25006675-png/wattseye/assets/full-system-architecture-clean.png

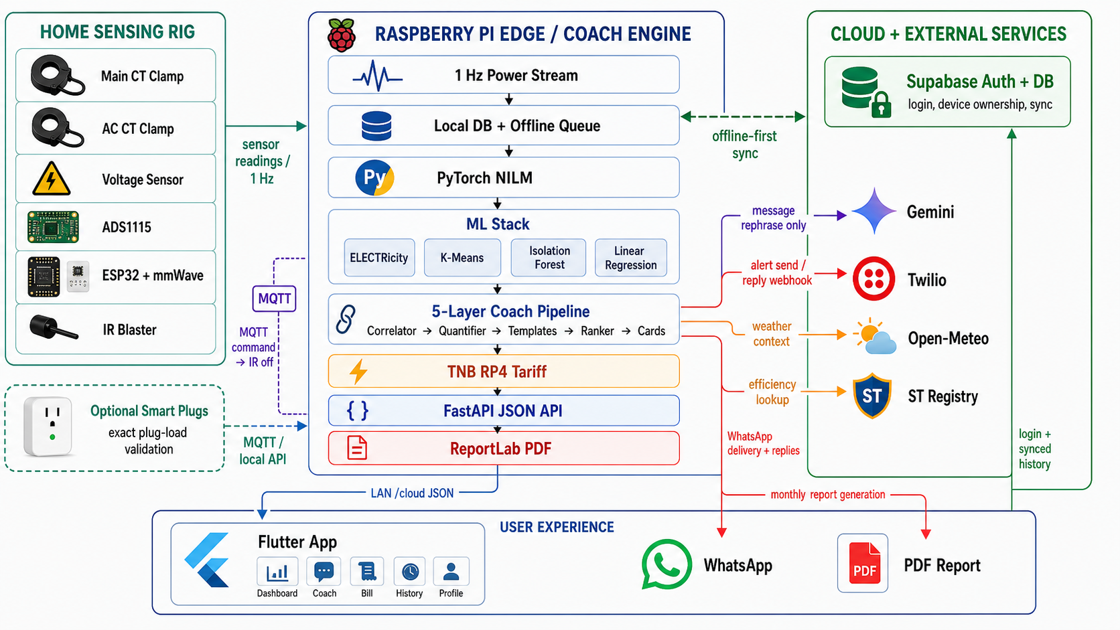
assets/full-system-architecture-clean.png
