25006675-png/wattseye/assets/wattseye-architecture-meta-cloud-api.png

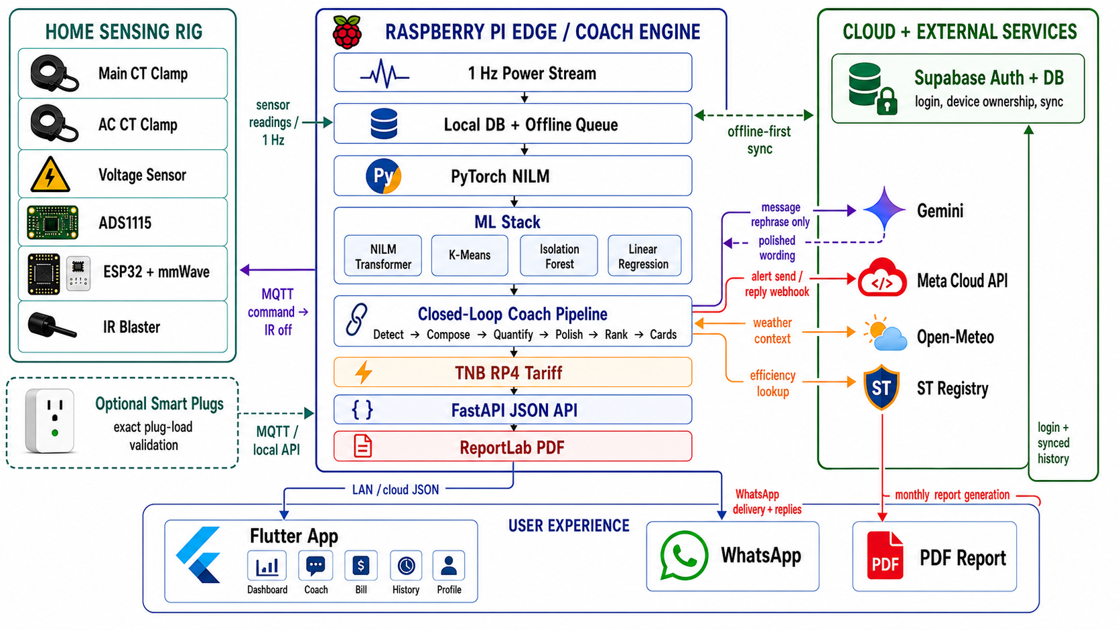
assets/wattseye-architecture-meta-cloud-api.png
