25006675-png/wattseye/wattseye_report_detailed.pdf

# WattsEye Monthly Report

Choong Zhuo Lin - Petaling Jaya - May 2026 | WE

TOTAL USED

# 1480 kWh

PROJECTED BILL
RM 503

YOU SAVED
RM 18

VS LAST MONTH
-8%

40

50

60

Daily kWh (last 30 days)
TOP APPLIANCES | ACTIONS YOU TOOK
Air Conditioner | 42% | RM 211
Fridge | 18% | RM 91
Water Heater | 12% | RM 60
Kitchen / Other | 18% | RM 91
Lights & Fans | 10% | RM 50
- AC auto-off enabled (saved 9 min/day avg)
- Shifted dishwasher to off-peak (4 runs)
- Reduced overnight standby (-18W)
- Confirmed routine baseline for kettle

TARIFF INSIGHT
Tariff plan: TNB RP4 Standard. Projected month: 1480 kWh.
ToU comparison: switching could save ~RM 12/month at your usage split. Tier band: 1480/1,500 kWh used (99% of high-band cliff)
Sources: TNB RP4 schedule | Open-Meteo weather | ST efficiency registry | Generated by WattsEye | Page 1 of 4

## Per-Appliance Breakdown

May 2026 - 5 tracked appliances | WE
Air Conditioner | RM 211
622 kWh this month - 42% of bill | Peak: 20:00 - 23:00
M | T | W | T | F | S | S
Fridge | RM 91
266 kWh this month - 18% of bill | Peak: all day (cycling)
M | T | W | T | F | S | S
Water Heater | RM 60
178 kWh this month - 12% of bill | Peak: 06:00 - 08:00, 19:00 - 22:00
M | T | W | T | F | S | S
Kitchen / Other | RM 91
266 kWh this month - 18% of bill | Peak: 07:00 - 09:00, 18:00 - 20:00
M | T | W | T | F | S | S
Lights & Fans | RM 50
148 kWh this month - 10% of bill | Peak: 18:00 - 23:00
M | T | W | T | F | S | S

Non-AC appliances are estimated via NILM (ELECTRIcity Transformer trained on UK-DALE + ENERTALK). Air Conditioner is measured directly via the dedicated CT clamp.
Sources: TNB RP4 schedule | Open-Meteo weather | ST efficiency registry | Generated by WattsEye | Page 2 of 4

## Recommendation Log

May 2026 - 12 archetypes tracked | | WE
ACTED ON (4)
- AC auto-off enabled | saved RM 9.85/mo | Acted May 8
- Dishwasher shifted off-peak | saved RM 5.30/mo | Acted May 11
- Standby load reduced | saved RM 2.40/mo | Acted May 15
- Routine baseline confirmed | improves alert accuracy | Acted May 18

ACTIVE (5)
- Tier cliff approaching | save RM 18 if you stay <1500 kWh | High severity
- Switch to TNB ToU | save RM 12/month | Medium severity
- Bill trending +25% vs avg | RM 19 over baseline | High severity
- AC efficiency upgrade | RM 230/year potential | Capital decision
- Routine shift detected | +90 min later this month | Low severity

DISMISSED (3)
- Hot week pre-cool reminder | user dismissed May 12
- Phantom standby alert | user dismissed May 14
- Simultaneous peak warning | user dismissed May 20

Net effect this month: 4 actions taken, RM 17.55/month recurring savings established. Coach learns from every accept / dismiss to re-rank future recommendations.

Sources: TNB RP4 schedule | Open-Meteo weather | ST efficiency registry | Generated by WattsEye | Page 3 of 4

## Tariff Math

TNB RP4 (1 Jul 2025 - 31 Dec 2027) - full bill breakdown | | WE
STANDARD TARIFF (1480 kWh projected)
Generation - low band (≤1500 kWh) | 1480 kWh × 27.03 sen | RM 400.04
Generation - high band (>1500 kWh) | 0 kWh × 37.03 sen | RM 0.00
Capacity charge | 1480 kWh × 4.55 sen | RM 67.34
Network charge | 1480 kWh × 12.85 sen | RM 190.18
Energy Efficiency Incentive (EEI) | band-tiered rebate | RM 0.00
Retail charge | waived if ≤600 kWh | RM 10.00
AFA (Automatic Fuel Adjustment) | current month | RM 0.00
Projected total | | RM 667.56

STANDARD vs TIME-OF-USE

STANDARD
RM 667.56
45.11 sen/kWh effective | TIME-OF-USE (recommended)
RM 655.56
saves RM 12.00/month - 35% peak / 65% off-peak RP4 TIER BAND POSITION
| | 1500 cliff

You are at 1480 kWh (99% of the 1500 kWh cliff). Above 1500 kWh, generation rate jumps 27.03 → 37.03 sen/kWh on every unit.

WHAT-IF SCENARIOS
- Stay below 1500 kWh | trim 0 kWh | save RM 3-18/mo
- Reduce AC by 1 hour/day | approx 30 kWh/month | save RM 10/mo
- Switch to ToU + shift dishwasher | 65% off-peak | save RM 12/mo

All rates from TNB RP4 schedule effective 1 July 2025 - 31 December 2027. Math is reproducible from ML/insights/tnb_tariff.py with cited source URLs.
Sources: TNB RP4 schedule | Open-Meteo weather | ST efficiency registry | Generated by WattsEye | Page 4 of 4
