25006675-png/wattseye/(commit log)

2026-05-18 docs(plan): pivot to hybrid sensing architecture (dedicated AC clamp + NILM)
    Restore the original winning pitch's AC-focused architecture and add NILM
    as an upgrade on top. Two CT clamps inside the DB box: one on the main
    feeder for whole-home NILM disaggregation, one on the dedicated AC
    circuit for exact AC measurement.
    Why: inverter ACs dominate Malaysian homes today and have no clean NILM
    signature, so AI alone cannot reliably detect AC. A dedicated clamp
    solves the inverter AC problem, enables a live IR cutoff demo via an
    IR receiver + relay block, and provides a quantified "agreement %"
    between NILM's AC estimate and the direct measurement.
    Doc updates:
    - 00_BIG_PICTURE: hybrid pitch,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
2026-05-23 feat: ship Coach engine, WhatsApp integration, and report stack
    Backend (ML/insights/coach/)
    - 5-layer pipeline: correlator -> quantifier -> templates -> ranker
    - 12 recommendation archetypes across 5 families (waste / tariff /
    forecast / context / capital)
    - TNB RP4 tariff calculator drives RM impact for every card
    - Open-Meteo client (free, 9 MY cities, 1h cache) for weather context
    - ST efficiency registry (6 appliance categories: fridge, AC, water
    heater, washing machine, ceiling fan)
    - Weekly digest as archetype #13
    WhatsApp + Gemini
    - Twilio sandbox send (whatsapp.py) + Flask webhook (whatsapp_webhook.py)
    - Two-stage reply classifier: keyword matcher first, Gemini 2.5 Flash
    fall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
    [demo_history.csv, efficiency_registry.csv, synthetic_history.csv]
2026-05-24 Wire WhatsApp alerts through backend API
2026-05-24 docs(hardware): add as-built hardware connection guide
    Step-by-step wiring and code for the exact parts purchased (SCT-013 30A/1V
    clamps, ZMPT101B, ADS1115, LD2410C, IR LED/VS1838B, 5V relay, mains box).
    Flags the 30A/1V clamp's built-in burden resistor and maps the live-data
    seam to dashboard_payload() in backend/api_server.py.
2026-05-25 feat(whatsapp+hardware): Meta Cloud API migration + live hardware pipeline
    WhatsApp: replace Twilio with Meta WhatsApp Cloud API end to end.
    - whatsapp.py: MetaConfig + Graph API send (text + hello_world template)
    - whatsapp_webhook.py: GET verification handshake, JSON payload parsing,
    acks POSTed back via Graph API (no TwiML)
    - api_server.py: MetaConfig status; .env.example Meta vars
    - docs: replace twilio_setup.md with meta_setup.md run sheet
    Hardware: ship the live pipeline the plan only described.
    - ML/sensing/ads1115_reader.py: ADS1115 -> PowerReading -> MQTT wattseye/power
    (with --simulate so it runs with no hardware)
    - backend/pi_bridge.py: subscribe power+occupancy, empty-room d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
    [ads1115_reader.py, arduino_ir_learn.ino, esp32_node.ino]
2026-05-26 @ docs(build_now): add step-by-step end-to-end build guide
    Adds docs/build_now/ — a beginner, click-by-click build guide ordered to the
    real build sequence (software -> Pi -> low-voltage hardware -> mains ->
    calibration), complementing the HARDWARE_CONNECTION.md reference.
    Steps: 01 laptop software loop, 02 Pi flash+SSH setup, 03 install+run on Pi
    (deps, PyTorch-on-ARM, services), 04 breadboard circuits, 05 sensing chain
    (ADS1115<->Pi, clamps, ZMPT), 06 ESP32 node, 07 mains box (assemble/inspect/
    energise/test), 08 calibration, 09 optional IR-learn (real-AC only).
    @
2026-05-29 checkpoint: NILM eval verification, signature edge-detection, coach prep
    - Add faithful ELECTRIcity model (ML/NILM/electricity_model.py) + reproducible
    eval harness (ML/NILM/eval/) verifying the published UK-DALE F1 scores
    (kettle .96 / fridge .86 / washer .80 / hair_dryer .76 / iron .68).
    - Rewrite signature_library event detection to edge/delta (Hart-style) so it
    isolates appliances by switch-on step, not absolute residual level.
    - Flag the approximate test_nilm_inference.py reconstruction; correct plan/03
    architecture notes; add QA defense 3b on unknown-load identification limits.
    - Bundle in-progress coach/feedback work and assorted docs.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
2026-05-29 feat(coach+app): wire coach to real data, add live/showcase modes, real AC cutoff
    Backend:
    - snapshot_builder.py: build a real HomeSnapshot from the Pi live_state or the
    synthetic_history/bench log (events, projected kWh, standby, peak fraction,
    AC routine baseline) so the coach runs on data, not the _demo_snapshot literal.
    - /api/coach/cards?mode=showcase|live; each card tagged data_source
    (live/replay/showcase). live = Pi feed, else bench log, else demo.
    - POST /api/ac/cutoff publishes the MQTT off-command (honest degrade when paho
    / broker absent).
    Flutter app (5 tabs kept, minimal styling):
    - Coach tab Showcase/Live SegmentedButton + per-card LIVE/REPLAY chip.
    - Bill page wired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
2026-05-29 feat(nilm): wire guarded live NILM runtime into pi_bridge
    - backend/nilm_runtime.py: rolling-window per-appliance disaggregation using the
    faithful ELECTRiCITY Discriminator (electricity_model.py). Bins to 6s, left-pads,
    midpoint readout, cutoff->watts + on/off thresholds.
    - pi_bridge: behind WATTSEYE_NILM=1 (off by default), feeds residual to the runner,
    infers every ~6s, emits per-appliance tiles; falls back to the 'other' bucket.
    Self-test still passes with NILM off.
    - Validated: port byte-exact vs training repo (max diff 0.0); real UK-DALE House-2
    kettle window -> ~2130W vs 2879W gt.
    - Documented hard limits: brittle to normalisation (needs UK-DALE train stats
    ~300/471; 522/8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
2026-05-29 fix(nilm): recent-max readout for low-latency live detection
    The fixed midpoint readout reflects ~window/2 ago (useless live). Read the max
    over the last ~80 output bins instead. Validated end-to-end through NilmRunner on
    a real UK-DALE House-2 kettle stream: kettle detected at ~2143W, top hit, ~1-2 min
    latency. Documented cross-talk to similar-wattage resistive models (hair dryer).
2026-05-29 feat(coach): showcase mode renders all 12 archetypes as a labelled catalog
    _demo_snapshot only fires 10 (and #4 tou_switch / #6 peak_window_shift are
    mutually exclusive in one home). Add _peak_heavy_snapshot companion that fires
    #3 + #6, and assemble showcase as the union (one card per archetype, sorted) so
    the demo shows all 12 grouped by family (app already colours by family). Live
    mode unchanged (stays sparse/honest). Relabel showcase as 'catalog - not one
    real home'.
2026-05-29 feat(app+docs): AC hero card, PDF export button, agent onboarding
    - Dashboard: add an AC hero card at the top (direct-measured AC watts + occupancy
    + empty-room alert + Turn-off control) so the UI leads with the product thesis.
    Move the cutoff button there; high-priority coach card keeps WhatsApp + detail.
    - Bill: add 'Download monthly report (PDF)' button -> existing /api/report/monthly
    via url_launcher (new dep).
    - ONBOARDING.md: agent-facing quick guide (map, real-vs-demo, gotchas, run, open items).
    flutter analyze: no issues.
2026-06-04 diag(sensing): raw ADS1115 front-end check (unscaled pin V, bias + Vpp)
    Prints raw per-channel voltage so a working input can be told from a
    floating/unbiased one before any calibration. Diagnoses the case where
    readings ignore the load (phantom current, noise-only voltage).
    [diag_raw.py]
2026-06-05 Move raw diagnostic main current to A3
2026-06-05 Read main current from ADS1115 A3
2026-06-05 fix(sensing): wait for MQTT CONNACK before publishing power readings
    The reader printed "connected" right after loop_start() without waiting
    for the broker handshake, so the first qos=0 publishes fired with NO_CONN
    and paho dropped them silently. Block until is_connected(), surface the
    CONNACK rc, and check publish() return codes so drops are no longer silent.
    Pin the paho 2.x callback API version (also silences the deprecation warning).
    [ads1115_reader.py]
2026-06-05 fix(sensing): survive transient I2C read errors instead of crashing
    The hardware read had no error handling, so a single I2C glitch (OSError Errno 5, seen on power blips) killed the reader permanently and froze live data. Catch OSError per tick, log it, skip the bad sample, and keep running.
    [ads1115_reader.py]
